cristianostrobbe/extrusion-workstation-builder/BOM.md

# JLCMC BoM

Prices are JLCMC unit prices in USD, taken from the jlcmc.com price API on 2026-11-09, at the quantity tier for the quantity shown.
Prices exclude shipping, EU VAT (22%) and wood panels.
Profile finish: H6 = natural (silver) sandblasted anodized. B2 = black, W1 = white, for about +5–7%.

## Printer workstation: two towers (930 W x 420 D x 1150 H frame, +24 mm end cap +71 mm caster = 1245 mm)

Layout: two identical bays, each 420 mm wide inside.
- Each bay has a tower above the deck, sized for a Bambu P1S with an AMS on top.
- Below the deck, each bay has a bottom shelf and a middle shelf.

Generated by `frame_bom.py`. The order file is `jlcmc_bom.xlsx` (JLCMC "BOM / RFQ" template); the same content is in `jlcmc_bom.csv`.
Quantities are order quantities: small parts include about 10% spare, and the Remark column shows how many are needed.
The configurator in `web/index.html` builds the same BoM for other sizes.

How it fastens together (no drilling or tapping of the aluminium):
- Each TPEA bracket uses 2 x (M6x12 + washer + drop-in T-nut).
- Each TPRE end cap clamps its post with 2 x (M6x12 + T-nut).
- Each panel uses 3 x M6x20 countersunk screws (flush) into T-nuts.

| Qty | JLCMC model number | Description | Unit $ | Total $ | Remark |
|---:|---|---|---:|---:|---|
| 6 | TXCK-H6-3030-L1150 | Aluminum extrusion EU 30 series 3030, 8 mm slot, natural sandblasted anodized, cut to 1150 mm | 5.0743 | 30.45 | 6x post tall; ends square, no machining |
| 16 | TXCK-H6-3030-L420 | Aluminum extrusion EU 30 series 3030, 8 mm slot, natural sandblasted anodized, cut to 420 mm | 1.8515 | 29.62 | 8x X beam left + 8x X beam right; ends square, no machining |
| 12 | TXCK-H6-3030-L360 | Aluminum extrusion EU 30 series 3030, 8 mm slot, natural sandblasted anodized, cut to 360 mm | 1.5772 | 18.93 | 12x Y beam; ends square, no machining |
| 65 | TPEA-308-3030 | die-cast corner bracket, 30 series | 0.1336 | 8.68 | needed 56, +9 spare |
| 165 | TPAH-N-8-M6 | M6 drop-in T-nut, 30 series | 0.0120 | 1.98 | needed 148, +17 spare |
| 140 | EDLG-S1-M6-L12 | M6x12 button head screw (brackets, end caps) | 0.0232 | 3.25 | needed 124, +16 spare |
| 30 | EDLJ-S1-M6-L20 | M6x20 countersunk socket screw DIN 7991 (panels, flush) | 0.0313 | 0.94 | needed 24, +6 spare |
| 125 | EPDA-S1W-B-6 | M6 flat washer (brackets) | 0.0055 | 0.69 | needed 112, +13 spare |
| 6 | TPRE-G306-3030-M8 | end cap with M8 female thread (caster mount) | 0.5847 | 3.51 | needed 6 |
| 6 | DEPN-W2-40-N | leveling caster, M8 stem, 50 kg, H 71 mm | 2.0193 | 12.12 | needed 6 |
| | | **Parts total (about 19 kg)** | | **$110.16** | |

Panels: 8 x 465x420 mm, 12 mm plywood, buy locally. CNC/laser cutting files are in `cad/panels/` (DXF, mm, viewed from the top):

| File | Qty | Used for |
|---|---:|---|
| panel_A_465x420_qty3.dxf | 3 | left bottom, mid, deck |
| panel_B_465x420_qty3.dxf | 3 | right bottom, mid, deck (mirror of A) |
| panel_C_465x420_qty1.dxf | 1 | left tower top |
| panel_D_465x420_qty1.dxf | 1 | right tower top (mirror of C) |

- Layer CUT holds the outline and the Ø6.5 through holes. Layer CSK90_D12.5_TOP marks the 90° countersinks to Ø12.5, cut from the top face.
- Notches are plain rectangles with 1 mm clearance around the posts. Inside corners are R3 (6 mm end mill), outside corners R5.
- The bottom beams sit 60 mm above the post ends so their brackets clear the TPRE clamps.

Clear space:
- Tower: 508 mm above the deck panel, so a P1S (458 mm) has 50 mm of head room.
- Bottom and middle compartments: 213 mm each (brackets take about 35 mm within 35 mm of each post).
- Deck surface 707 mm above the floor, tower top 1257 mm, about 1483 mm with an AMS 2 Pro on top.

Example only, not in the BoM: SKÅDIS 36x56 on the left tower side, fixed with 6 x EDLG-S1-M6-L30 (about $0.28) + washers + T-nuts + 17 mm printed spacers.
