cristianostrobbe/extrusion-workstation-builder/jlcmc_bom.csv

*Customer Part # | JLCMC Part # | *Product Description | *Quantity | Remark
WS-01 | TXCK-H6-3030-L1150 | Aluminum extrusion EU 30 series 3030, 8 mm slot, natural sandblasted anodized, cut to 1150 mm | 6 | 6x post tall; ends square, no machining
WS-02 | TXCK-H6-3030-L420 | Aluminum extrusion EU 30 series 3030, 8 mm slot, natural sandblasted anodized, cut to 420 mm | 16 | 8x X beam left + 8x X beam right; ends square, no machining
WS-03 | TXCK-H6-3030-L360 | Aluminum extrusion EU 30 series 3030, 8 mm slot, natural sandblasted anodized, cut to 360 mm | 12 | 12x Y beam; ends square, no machining
WS-04 | TPEA-308-3030 | die-cast corner bracket, 30 series | 65 | needed 56, +9 spare
WS-05 | TPAH-N-8-M6 | M6 drop-in T-nut, 30 series | 165 | needed 148, +17 spare
WS-06 | EDLG-S1-M6-L12 | M6x12 button head screw (brackets, end caps) | 140 | needed 124, +16 spare
WS-07 | EDLJ-S1-M6-L20 | M6x20 countersunk socket screw DIN 7991 (panels, flush) | 30 | needed 24, +6 spare
WS-08 | EPDA-S1W-B-6 | M6 flat washer (brackets) | 125 | needed 112, +13 spare
WS-09 | TPRE-G306-3030-M8 | end cap with M8 female thread (caster mount) | 6 | needed 6
WS-10 | DEPN-W2-40-N | leveling caster, M8 stem, 50 kg, H 71 mm | 6 | needed 6
