cristianostrobbe/extrusion-workstation-builder/cad/panels/panel_D_465x420_qty1.dxf

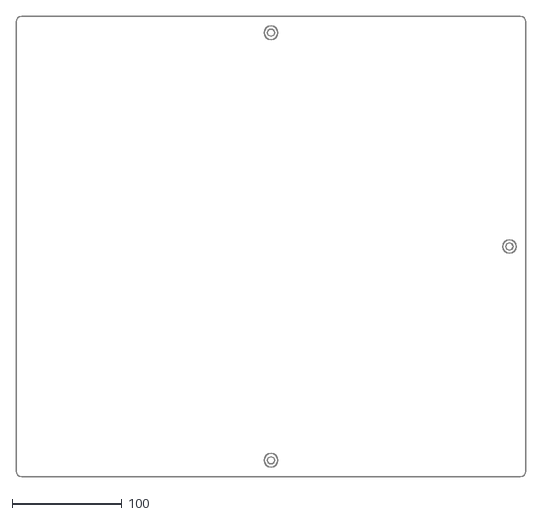
[picture p1: CAD file, 2026-11-09]
cad/panels/panel_D_465x420_qty1.dxf
465.0 x 420.0
