cristianostrobbe/extrusion-workstation-builder/cad/workstation.step

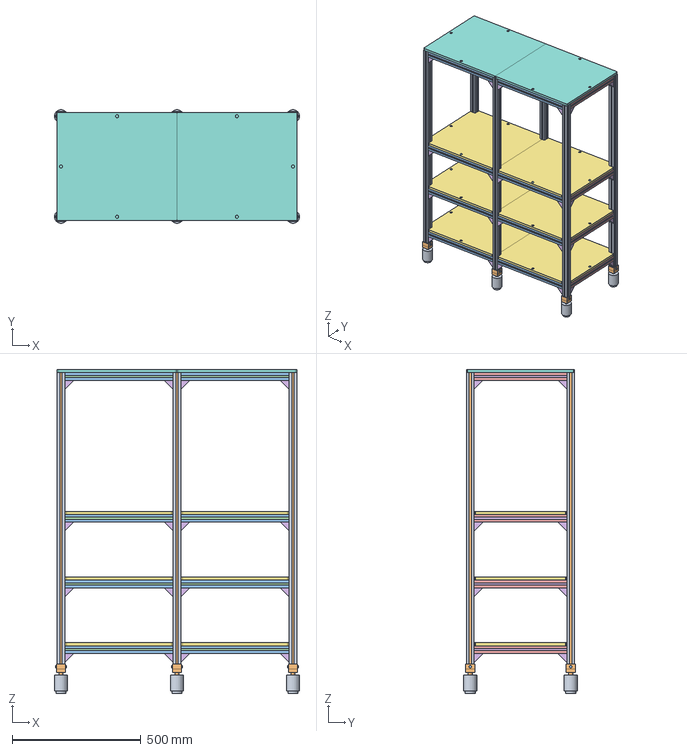
[picture p2: CAD file, 2026-11-09]
cad/workstation.step
951.0 x 440.6 x 1257.0 mm
