cristianostrobbe/extrusion-workstation-builder/cad/panels/panel_B_465x420_qty3.dxf

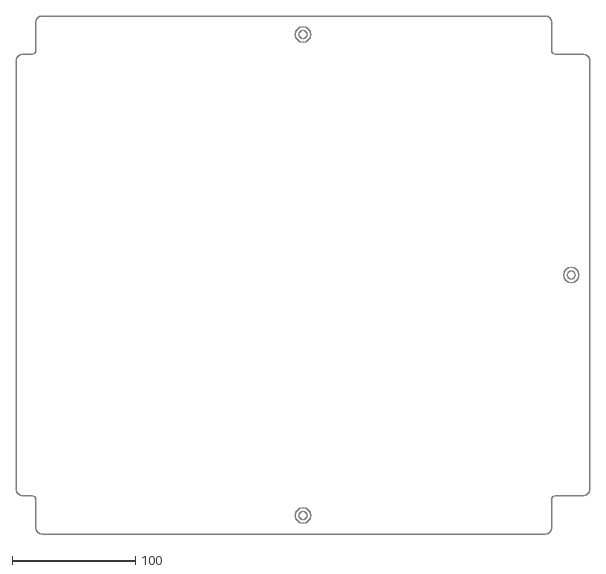
[picture p4: CAD file, 2026-11-09]
cad/panels/panel_B_465x420_qty3.dxf
465.0 x 420.0
