cristianostrobbe/extrusion-workstation-builder/(list of files, cad)

Other CAD files:
cad/workstation.FCStd
