cristianostrobbe/extrusion-workstation-builder/(commit log)

2026-11-09 Add twin-tower 3D-printer workstation design and JLCMC BoM
    - frame_bom.py: parametric 3030 cut list and hardware list; writes
    jlcmc_bom.xlsx / .csv in the JLCMC BOM upload template format
    - cad/workstation.py: parametric FreeCAD model (frame, brackets,
    fasteners, casters, panels, reference objects); exports FCStd, STEP
    and panel DXF cut files
    - BOM.md: priced BoM and panel cut files
    Frame 930 x 420 x 1150 mm: two 420 mm bays, each a printer tower with
    508 mm clear above the deck, two shelves below, on leveling casters.
    [jlcmc_bom.csv, jlcmc_bom.xlsx, panel_A_465x420_qty3.dxf, panel_B_465x420_qty3.dxf, panel_C_465x420_qty1.dxf, panel_D_465x420_qty1.dxf, workstation.FCStd, workstation.step]
2026-11-09 Add web configurator with JLCMC BoM, STEP/DXF export and shipping estimate
    Single-page tool (web/index.html) that sizes the 3030 workstation bay by
    bay and previews it in 3D:
    - live JLCMC BoM in the BOM/RFQ template columns, .xlsx/.csv export;
    prices from the jlcmc.com price API (profiles and acrylic interpolated)
    - optional acrylic doors, side and back panels with hinges and fixings
    - STEP assembly (profiles, floor panels, acrylic) and 1:1 panel DXFs
    sorted into doors/, side_panels/ and floor/, both as .zip
    - shipping estimate scaled from a sample JLCMC cart to Italy, adjustable
    from your own cart, with options to buy profiles or acrylic locally
    - printer fit, head room and caster loa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
2026-11-14 Add beta notice and feedback form to the configurator
    The tool isn't validated yet: a notice under the title says so and links to a
    feedback section at the bottom of the page. The form opens a pre-filled GitHub
    issue (topic, message, optional contact, the current design as JSON) or copies
    the same text for a DM.
2026-11-14 Feedback form: put the Instagram DM route first
    GitHub issues need a signed-in GitHub account, so most visitors can't use them.
    "Copy for an Instagram DM" is now the main button, the note says no account is
    needed, and an "Open Instagram" link appears once IG (the handle) is set.
2026-11-14 Rename to Workstation Builder and add an Italian version
    The page is no longer only for printer stands, so it's now "Workstation
    Builder" with a plainer description. An EN / IT switch in the header
    translates every label, check, total and message; ?lang=it in the link,
    the visitor's last choice or an Italian browser opens it in Italian.
    Exported files stay in English for JLCMC's upload template.
